OzanE1/CCM7/CCM7.docx

CCM7

STM32H750: ARM-Cortex M7-based generalized control computer. The necessary peripheral units for autonomous robotic systems are integrated. It carries 1 6DOF IMU, 1 3DOF magnetometer, 1 barometer, and 1 RF/Bluetooth module. It features 8 PWM outputs, usb, telemetry, gps, compass, PPM, and 2x20 GPIO pin outputs.

1 SYSTEM

PROCESSOR SYSTEM
N | MCU Hierarchy | MCU Name
MA | Main MCU | STM32H743VGT6
NRF | NRF MCU | nRF52820

CLOCK
N | Name | Name | Pin Name | MCU-N
X1 | 32MHz External HSE Oscillator | RCC-IN RCC-OUT | PH0 PH1 | MA
X2 | 32MHz External HSE Oscillator | RCC-IN RCC-OUT | XC1 XC2 | NRF

COM CONNECTIONS
N | Connection Name | Label | Pin Name | MCU-N
H1 | SWD | SWCLK SWDIO NRST | PA14 PA13 NRST | MA
H2 | NRF_SWD | NRF_SWCLK NRF_SWDIO NRF_NRST | SWCLK SWDIO P0.18 | NRF
H3 | USB | USB_DM USB_DP | PA11 PA12 | MA
H4 | UART1 | UART1_TX UART1_RX | PA9 PA10 | MA
H5 | UART2 | UART2_TX UART2_RX | PA2 PA3 | MA
H6 | UART3 | UART3_TX UART3_RX | PD8 PD9 | MA
H7 | UART4 | UART4_TX UART4_RX | PB9 PB8 | MA
H8 | I2C1 | I2C1_SCL I2C1_SDA I2C1_IRQ1 I2C1_IRQ2 I2C1_IRQ3 | PB6 PB7 PE13 PE14 PE15 | MA
H9 | I2C2 | I2C2_SCL I2C2_SDA | PB10 PB11 | MA
H10 | SPI1 | SPI1_SCK SPI1_MISO SPI1_MOSI SPI1_CS1 SPI1_CS2 SPI1_CS3 | PA5 PA6 PA7 PC4 PC5 PB0 | MA
H11 | SPI3 | SPI3_SCK SPI3_MISO SPI3_MOSI SPI3_CS SPI3_IRQ | PC10 PC11 PC12 PD0 PD1 | MA
H12 | NRF_SPI0 (Master) | NRF_SPI0_SCK NRF_SPI0_MISO NRF_SPI0_MOSI NRF_SPI0_CS | P0.00 P0.01 P0.04 P0.02 | NRF
H13 | NRF_SPI1 (Slave) | NRF_SPI1_SCK NRF_SPI1_MISO NRF_SPI1_MOSI NRF_SPI1_CS NRF_SPI1_IRQ | P0.05 P0.06 P0.07 P0.14 P0.15 | NRF
H14 | CAN2 | CAN2_RX CAN2_TX | PB12 PB13 | MA
H15 | PPM1 | PPM1 | PA0 | MA

PIN CONNECTIONS
N | Connection Name | Label | Pin Name | MCU-N
P1 | TIM3 | TIM3_CH1 TIM3_CH2 TIM3_CH3 TIM3_CH4 | PC6 PC7 PC8 PC9 | MA
P2 | TIM4 | TIM4_CH1 TIM4_CH2 | PD12 PD13 | MA
P3 | TRX1 | UART3_TX UART3_RX | PD8 PD9 | MA
P4 | ADC1 | ADC1 | PB0 | MA
P5 | ADC2 | ADC2 | PB1 | MA
P6 | LED0 | LED0 | PD3 | MA
P7 | LED1 | LED1 | PD4 | MA
P8 | LED2 | LED2 | PE10 | MA
P9 | LED3 | LED3 | PE11 | MA
P10 | NRF_PA | NRF_PA_RX_EN NRF_PA_TX_EN NRF_PA_MODE NRF_PA_PDN | P0.16 P0.17 P0.29 P0.08 | NRF
P11 | NRF_LED0 | NRF_LED0 | P0.28 | NRF
P12 | NRF_LED1 | NRF_LED1 | P0.30 | NRF

POWER MANAGEMENT
N | Regulator Voltage | Regulator Name | V out
E1 | VIN – 5V | TPS54202DDCR | 5V
E2 | 5V – 3.3V | ME6211C33M5G | 3V3
E3 | 5V – 3.3V | ME6211C33M5G | 3V3RF

MODULES
N | Module Name | Pinout | Peripheral
U0 | nRF21540 | 3V3RF – NRF_ANT – NRF | NRF_SPI1
U1 | nRF52820 | 3V3RF – MA | SPI3
U2 | USB Connector | DM – DP | USB
U3 | GPS Connector | 5V – TX – RX – GND | UART1
U4 | TRX Connector | 5V – TX – RX – GND | UART3
U5 | 24AA64T | 3.3V – SCL – SDA – GND | I2C1
U6 | BMI088 | 3.3V – SCK – MOSI – MISO – CS1 – CS2 – GND | SPI1
U7 | BMP581 | 3.3V – SCL – SDA – IRQ1 – GND | I2C1
U8 | BMM150 | 3.3V – SCL – SDA – IRQ2 – GND | I2C1
U9 | IIM42652 | 3.3V – SCK – MOSI – MISO – CS3 – GND | SPI1
U10 | ICP20100 | 3.3V – SCL – SDA – IRQ3 – GND | I2C1

U9 | PWM1 Connector | CH4 – 5V – GND | TIM3
| PWM2 Connector | CH3 – 5V – GND | TIM3
| PWM3 Connector | CH2 – 5V – GND | TIM3
| PWM4 Connector | CH1 – 5V – GND | TIM3
| PWM5 Connector | CH4 – 5V – GND | TIM4
| PWM6 Connector | CH3 – 5V – GND | TIM4
U10 | 2x20 2.54 Connector | 2x20 (Debug Area 2x5 : SWD + UART2,UART4) | 2x20
U11 | Power Connector | VIN – SDA – SCL – GND | I2C1
