OzanE1/CCM7/Modules/image.png

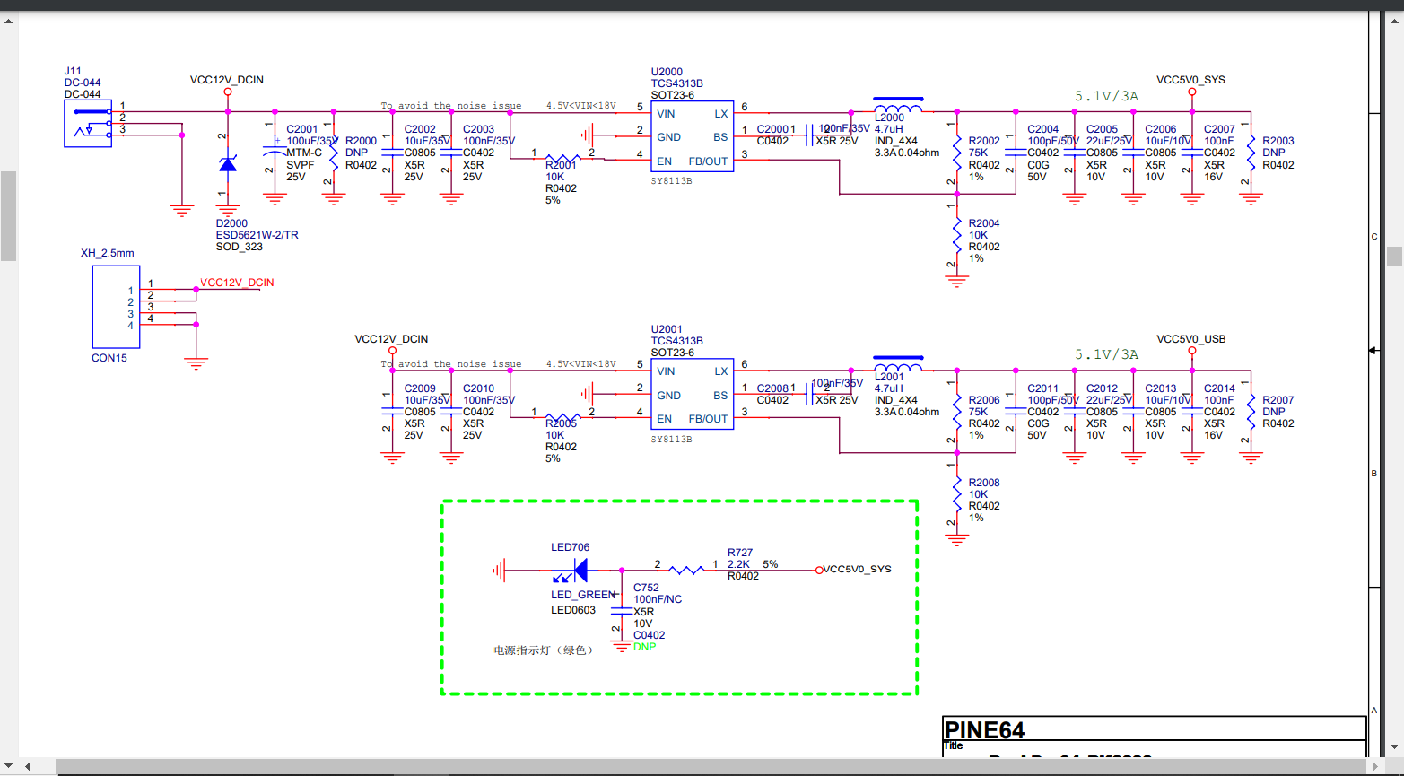
Modules/image.png
