OzanE1/CCM7/Sample-BOM_JLCSMT.xlsx

Comment | Designator | Footprint | Part Number
10uF | C1, | Capacitor_SMD:C_0603_1608Metric
10uF | C43, C57 | Capacitor_SMD:C_1206_3216Metric
100nF | C47 | Capacitor_SMD:C_1206_3216Metric
100nF | C2-C12, C14, C16, C19, C22-C27, C33, C38, C41, C42, C48, C54, C55 | Capacitor_SMD:C_0603_1608Metric
1uF | C13, C15, C36, C39, C46, | Capacitor_SMD:C_0603_1608Metric
1uF | C30, C45, C46, C50 | Capacitor_SMD:C_0805_2012Metric
2.2uF | C17, C18 | Capacitor_SMD:C_0603_1608Metric
16pF | C20, C21, C32, C44 | Capacitor_SMD:C_0603_1608Metric
2pF | C28 | Capacitor_SMD:C_0201_0603Metric
1pF | C29 | Capacitor_SMD:C_0201_0603Metric
100pF | C31 | Capacitor_SMD:C_0603_1608Metric
4.7uF | C34, C40 | Capacitor_SMD:C_0603_1608Metric
820pF | C35 | Capacitor_SMD:C_0603_1608Metric
47nF | C37 | Capacitor_SMD:C_0603_1608Metric
47pF | C49 | Capacitor_SMD:C_0603_1608Metric
100nF | C51 | Capacitor_SMD:C_0603_1608Metric
2.2uF | C52 | Capacitor_SMD:C_0603_1608Metric
10nF | C53 | Capacitor_SMD:C_0603_1608Metric
22uF | C56 | Capacitor_SMD:C_0805_2012Metric
MBR230LSFT1G | D1 | MBR230LSFT1G:SODFL3619X98N
LED | D2-D6 | LED_SMD:LED_0603_1608Metric
Polyfuse | F1 | Fuse:Fuse_1206_3216Metric
FerriteBead | FB1 | Inductor_SMD:L_0603_1608Metric
SMA_CONNECTOR | J9 | LPRS_SMA_CONNECTOR:LPRS_SMA_CONNECTOR
USB_B_Micro | J11 | Connector_USB:USB_Micro-B_Wuerth_629105150521
10uH | L1 | Inductor_SMD:L_0603_1608Metric
15nH | L2 | Inductor_SMD:L_0603_1608Metric
3.3uH | L3 | Inductor_SMD:L_Changjiang_FXL0650
1.9nH | L6 | Inductor_SMD:L_0201_0603Metric
3.0nH | L7 | Inductor_SMD:L_0201_0603Metric
4k7 | R1 | Resistor_SMD:R_0603_1608Metric
1.5k | R2, R7-R9, R14, R17 | Resistor_SMD:R_0603_1608Metric
620R | R3 | Resistor_SMD:R_0603_1608Metric
4.7k | R4, R5 | Resistor_SMD:R_0603_1608Metric
10k | R6, R15 | Resistor_SMD:R_0603_1608Metric
100K | R10 | Resistor_SMD:R_0603_1608Metric
1k | R11 | Resistor_SMD:R_0603_1608Metric
220K | R12 | Resistor_SMD:R_0603_1608Metric
30K | R13 | Resistor_SMD:R_0603_1608Metric
50R | R16 | Resistor_SMD:R_0603_1608Metric
SKRPABE010 | S1 | SW_SKRPABE010:SW_SKRPABE010
STM32H743VITx | U1 | Package_QFP:LQFP-100_14x14mm_P0.5mm
24AA64T-I/OT | U2 | Package_TO_SOT_SMD:SOT-23-5_HandSoldering
BMI088 | U3 | BMI088:PQFN50P450X300X100-16N
ICP-20100 | U4 | ICP-20100:PQFN50P200X200X85-10N
BMM150 | U5 | Package_CSP:WLCSP-12_1.56x1.56mm_P0.4mm
nRF52820-QDxx | U6 | Package_DFN_QFN:QFN-40-1EP_5x5mm_P0.4mm_EP3.6x3.6mm
NRF21540-QDAA-R7 | U7 | nRF21540:QFN65P400X400X95-17N
TPS562246DRLR | U8 | TPS562246DRLR:DRL0006A-MFG
ME6211C33M5 | U9, U10 | Package_TO_SOT_SMD:SOT-23-5
BMP581 | U11 | BMP581:BMP581
IIM-42652 | U12 | Package_LGA:Bosch_LGA-14_3x2.5mm_P0.5mm
32MHz | Y1, Y2 | Crystal:Crystal_SMD_3225-4Pin_3.2x2.5mm
