OzanE1/CCM7/EdgeCut/YeniayCC_2.dxf

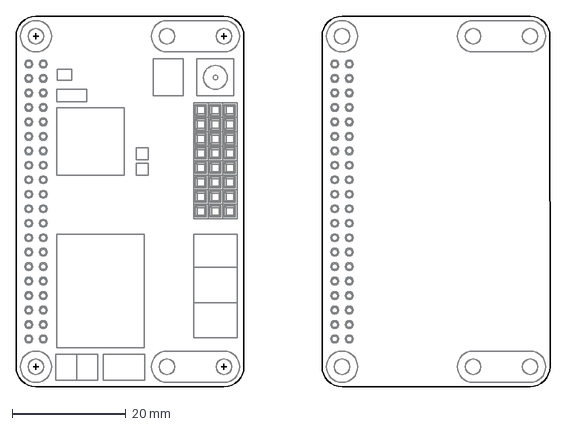
[picture p2: CAD file, 2025-02-13]
EdgeCut/YeniayCC_2.dxf
93.7 x 65.0 mm
