OzanE1/CCM7/Modules/74437349033/WE-LHMI_7050LHMI+%28rev1%29.stp

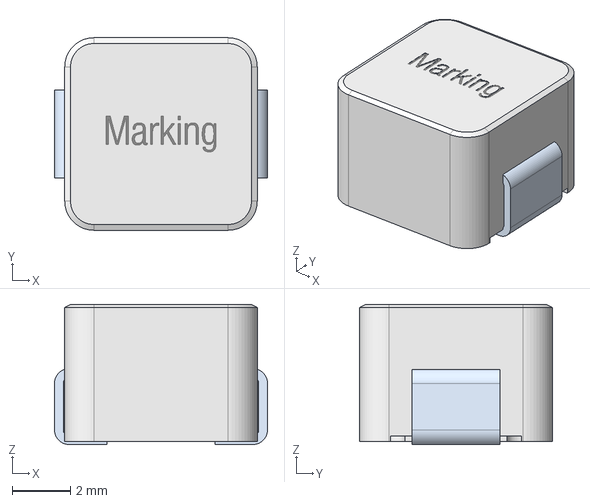
[picture p3: CAD file, 2025-04-21]
Modules/74437349033/WE-LHMI_7050LHMI+%28rev1%29.stp
7.30 x 6.60 x 4.80 mm
