OzanE1/CCM7/Modules/BMI088/BMI088--3DModel-STEP-56544.STEP

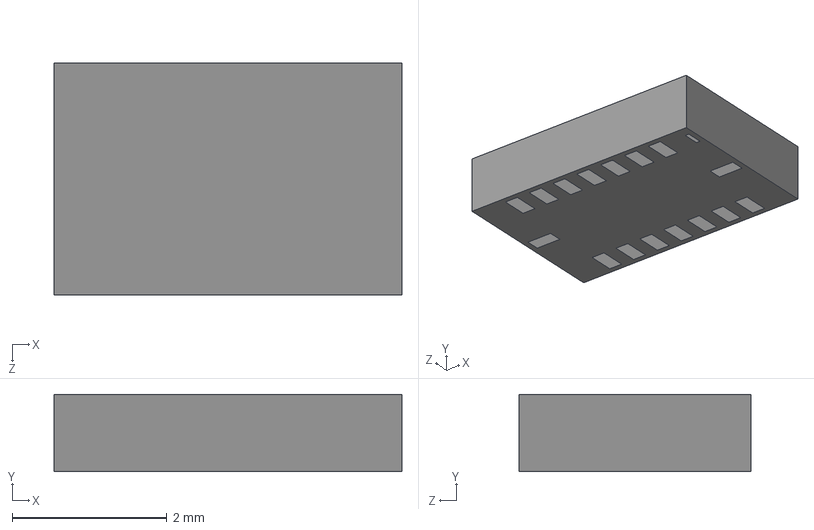
[picture p4: CAD file, 2025-04-20]
Modules/BMI088/BMI088--3DModel-STEP-56544.STEP
4.50 x 1.00 x 3.00 mm
