OzanE1/CCM7/Modules/BMM150/BMM150--3DModel-STEP-56544.STEP

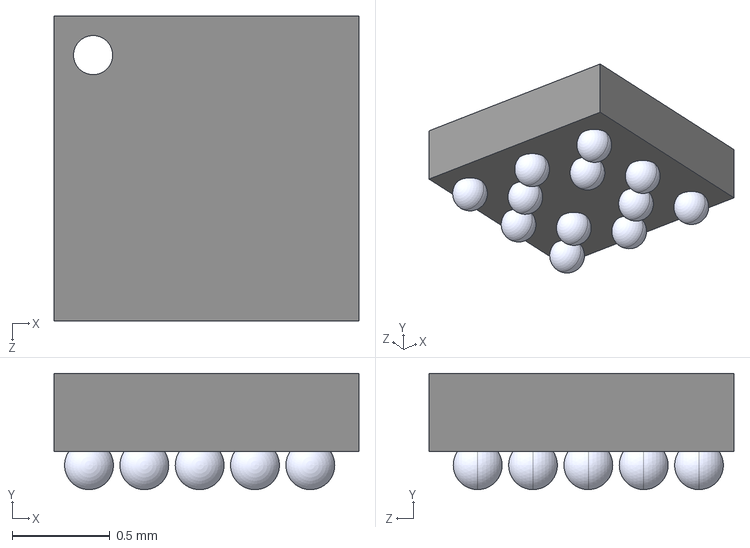
[picture p5: CAD file, 2025-04-20]
Modules/BMM150/BMM150--3DModel-STEP-56544.STEP
1.56 x 0.595 x 1.56 mm
Body^BMM150
Pin^BMM150 x 12
