OzanE1/CCM7/Modules/BMP581/BMP581--3DModel-STEP-653870.STEP

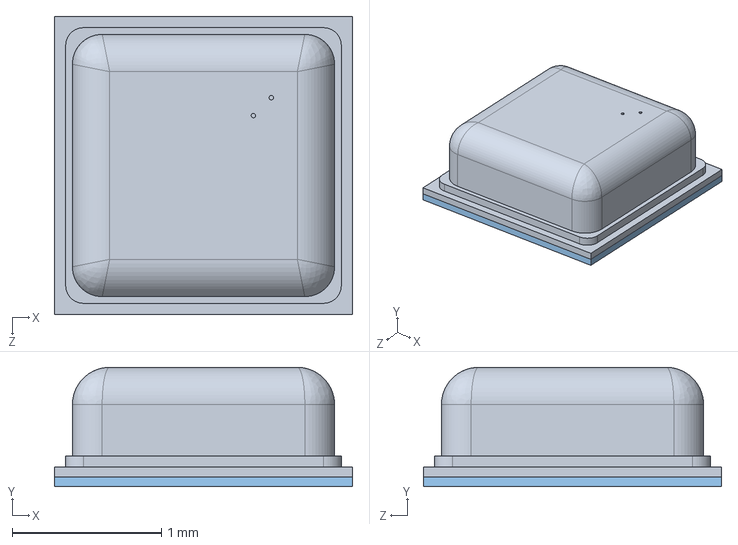
[picture p6: CAD file, 2025-04-20]
Modules/BMP581/BMP581--3DModel-STEP-653870.STEP
2.00 x 0.801 x 2.00 mm
