OzanE1/CCM7/Modules/ICP-20100/ICP-20100--3DModel-STEP-56544.STEP

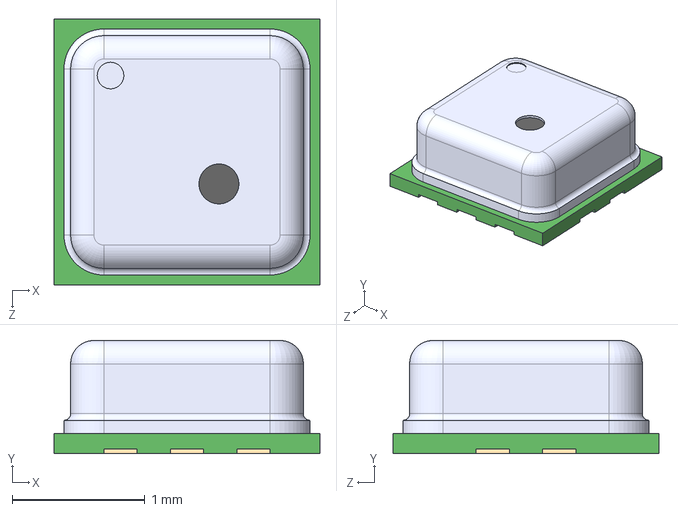
[picture p7: CAD file, 2025-04-20]
Modules/ICP-20100/ICP-20100--3DModel-STEP-56544.STEP
2.00 x 0.85 x 2.00 mm
