OzanE1/CCM7/Modules/MBR230LSFT1G/MBR230LSFT1G.STEP

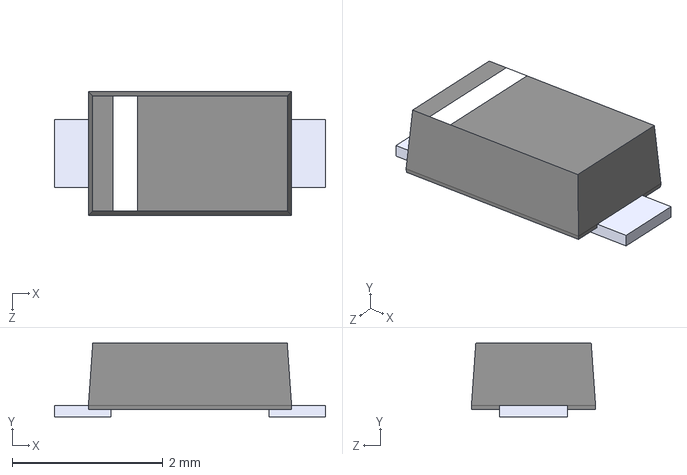
[picture p8: CAD file, 2025-04-21]
Modules/MBR230LSFT1G/MBR230LSFT1G.STEP
3.60 x 0.98 x 1.65 mm
