OzanE1/CCM7/Modules/NRF/nRF21540/QFN16_4X4_NOR.step

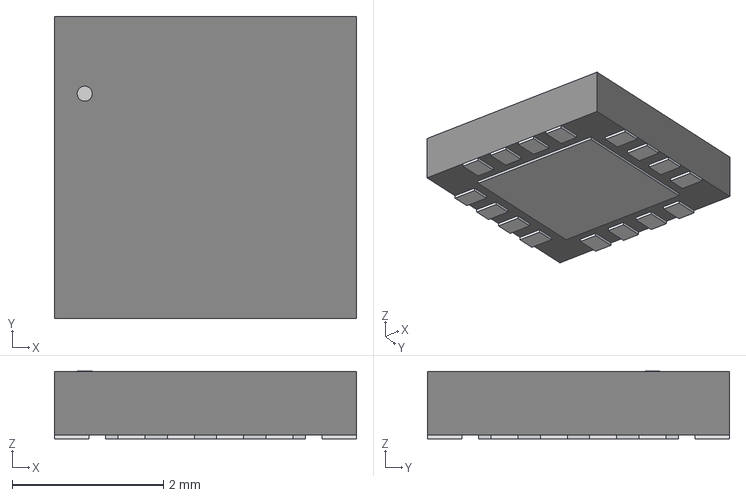
[picture p9: CAD file, 2025-04-21]
Modules/NRF/nRF21540/QFN16_4X4_NOR.step
3.99 x 3.99 x 0.892 mm
