OzanE1/CCM7/Modules/TPS562246DRLR/DRL0006A.stp

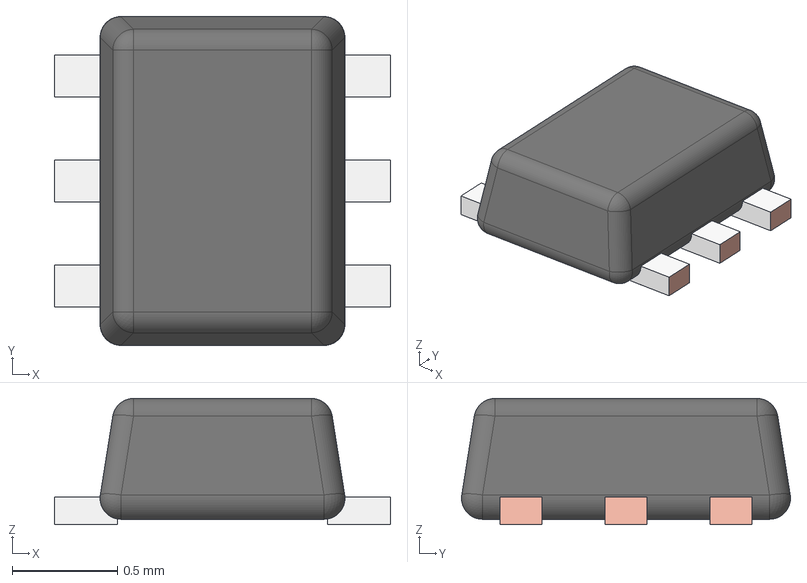
[picture p10: CAD file, 2025-04-21]
Modules/TPS562246DRLR/DRL0006A.stp
1.60 x 1.57 x 0.6 mm
FRAME-DRL0006A
BODY-SOT
PIN1-ID
