OzanE1/CCM7/Modules/USB_B_Micro_Wuerth/629105150521+%28rev1%29.stp

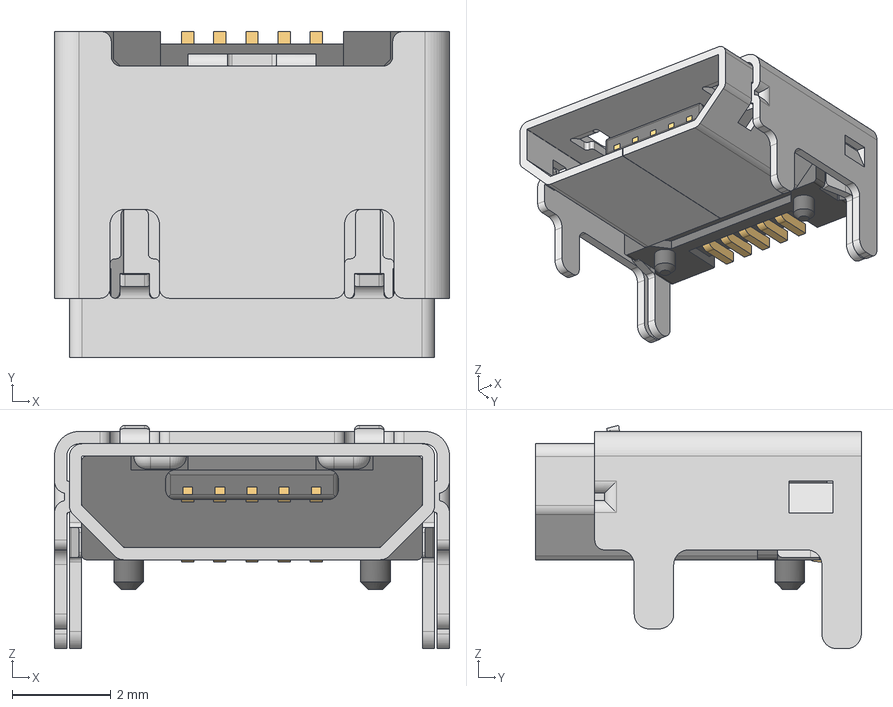
[picture p11: CAD file, 2025-04-20]
Modules/USB_B_Micro_Wuerth/629105150521+%28rev1%29.stp
8.00 x 6.60 x 4.52 mm
629105150521_Housing
629105150521_Pin1 x 4
629105150521_Pin2
629105150521_Shielding2
629105150521_Shielding
