OzanE1/CCM7/(commit log)

2024-10-31 Modules added.
    [BMM150.kicad_pcb, BMM150.kicad_sch, BMP388.kicad_pcb, BMP388.kicad_sch, ESP32-C3.kicad_pcb, ESP32-C3.kicad_sch]
2024-11-19 BMP388 updated.
    [BMP388.kicad_sch, ESP32-C3.kicad_sch, VOLTAGE_R.kicad_pcb, VOLTAGE_R.kicad_sch]
2024-11-19 BMM150 updated.
    [BMM150.kicad_sch, BMP388.kicad_sch]
2024-11-22 BMI088 updated.
    [BMI088.kicad_pcb, BMI088.kicad_sch]
2024-12-03 ESP32-C3 Updated.
2024-12-08 Voltage Regulator updated
    [VOLTAGE_R.kicad_sch]
2024-12-13 STM32H743VIT6 labels updated
    [ControlComputer.kicad_sch, ESP32-C3.kicad_sch]
2024-12-13 update schematic
    [CC_M7.kicad_sch, ESP32-C3.kicad_sch, Power.kicad_sch]
2024-12-14 nRF52820+nRf21540 add
    [CC_M7.kicad_sch, RF Telemetry.kicad_sch]
2024-12-14 update rf scheme
    [CC_M7.kicad_pcb, RF Telemetry.kicad_sch]
2024-12-15 nRF52820 schematic update
    [CC_M7.kicad_sch, Connections.kicad_sch]
2024-12-17 nrf52820 draw
    [nRF52840.kicad_pcb, nRF52840.kicad_sch]
2024-12-17 VoltageR updated
    [VOLTAGE_R.kicad_sch]
2024-12-24 label control
    [Connections.kicad_sch, ControlComputer.kicad_sch]
2024-12-27 Control board updated
    [ControlComputer.kicad_sch]
2024-12-27 Connectors updated
    [CC_M7.kicad_sch, Connections.kicad_sch, ControlComputer.kicad_sch, Power.kicad_sch]
2024-12-27 NRF pins updated
    [Connections.kicad_sch, RF Telemetry.kicad_sch, Sensors.kicad_sch]
2024-12-29 final schematic 6 warning
    [Connections.kicad_sch, ControlComputer.kicad_sch, Power.kicad_sch, RF Telemetry.kicad_sch, Sensors.kicad_sch]
2025-01-24 schematic control comment
    [Connections.kicad_sch, Power.kicad_sch, RF Telemetry.kicad_sch]
2025-02-01 CCM7.docx Updated Connector redefinition | Power Read Update
2025-02-01 Changes updated @ CCM7.docx
    [CC_M7.kicad_sch, Connections.kicad_sch, ControlComputer.kicad_sch, Power.kicad_sch, Sensors.kicad_sch]
2025-02-02 Footprint assignment 1/2
    [ControlComputer.kicad_sch, Power.kicad_sch, RF Telemetry.kicad_sch, Sensors.kicad_sch]
2025-02-08 IIM42652 schematic added
    [ControlComputer.kicad_sch, Power.kicad_sch, RF Telemetry.kicad_sch, Sensors.kicad_sch]
2025-02-08 New sensors
2025-02-08 BMP581 added schematic
    [Sensors.kicad_sch]
2025-02-09 net classes added
    [CC_M7_PCB.kicad_pcb]
2025-02-09 assigned footprint completed
    [Connections.kicad_sch, ControlComputer.kicad_sch, Power.kicad_sch, RF Telemetry.kicad_sch, Sensors.kicad_sch]
2025-02-09 BMP581 and ICP20100 added
    [ControlComputer.kicad_sch, Sensors.kicad_sch]
2025-02-12 ready to start PCB drawing
    [CC_M7.kicad_pcb, Connections.kicad_sch, Power.kicad_sch, RF Telemetry.kicad_sch, Sensors.kicad_sch]
2025-02-13 nRF PCB placement completed
    [CC_M7.kicad_pcb, ControlComputer.kicad_sch, RF Telemetry.kicad_sch, Sensors.kicad_sch, YeniayCC_2.dxf]
2025-02-18 Component placement completed
    [CC_M7.kicad_pcb, ControlComputer.kicad_sch, RF Telemetry.kicad_sch, Sensors.kicad_sch]
2025-02-18 Mounting Hole added.
    [CC_M7.kicad_pcb, CC_M7.kicad_sch, ControlComputer.kicad_sch, RF Telemetry.kicad_sch]
2025-02-20 1x04 connectors chosen and added
    [CC_M7.kicad_pcb, Connections.kicad_sch]
2025-02-21 constraints set
    [CC_M7.kicad_pcb]
2025-02-21 impadance control check and track thickness added
    [CC_M7.kicad_pcb]
2025-02-22 Schematic pdf added.
    [CC_M7.kicad_pcb, Power.kicad_sch, YeniayCC_2.dxf]
2025-02-22 Reverse current protection added.
2025-02-22 PCB track draw.
    [CCM7_Bom.csv, CC_M7.kicad_pcb, Connections.kicad_sch, ControlComputer.kicad_sch, Power.kicad_sch, RF Telemetry.kicad_sch]
2025-02-23 Reverse current protection added. | Routing progress.
    [CC_M7.kicad_pcb, Power.kicad_sch, Sensors.kicad_sch]
2025-02-23 Routing Progress | BMM150 removed.
    [CC_M7.kicad_pcb, ControlComputer.kicad_sch, RF Telemetry.kicad_sch, Sensors.kicad_sch]
2025-03-02 USB Pullup added, oscillator capacitors updated.
    [Connections.kicad_sch, ControlComputer.kicad_sch, RF Telemetry.kicad_sch]
2025-03-08 Routing | Silkscreen Design Completed. | Power Led Added. | Schematic PDF deleted | Mounting Hole Pad Clearance added. | BMM150 Conneciton Fixed.
    [CC_M7.kicad_pcb, CC_M7.kicad_sch, Connections.kicad_sch, ControlComputer.kicad_sch, Power.kicad_sch, RF Telemetry.kicad_sch, Sensors.kicad_sch]
2025-03-10 Small vias replaced big vias
    [CC_M7.kicad_pcb]
2025-03-31 error chekc
    [CC_M7.kicad_pcb]
2025-04-01 Error check
    [CC_M7.kicad_pcb]
2025-04-02 warning check
    [CC_M7.kicad_pcb, CC_M7.kicad_sch, Connections.kicad_sch, ControlComputer.kicad_sch, Power.kicad_sch, RF Telemetry.kicad_sch, Sensors.kicad_sch]
2025-04-02 Zones properties changed.
    [CC_M7.kicad_pcb]
2025-04-05 Error and warning completed check.
    [CC_M7.kicad_pcb]
2025-04-05 BOM added.
    [BOM.xlsx, CC_M7.kicad_pcb, Sample-BOM_JLCSMT.xlsx, Sensors.kicad_sch]
2025-04-20 Adding 3d models.
    [629105150521+%28rev1%29.stp, BMI088--3DModel-STEP-56544.STEP, BMM150--3DModel-STEP-56544.STEP, BMP581--3DModel-STEP-653870.STEP, CC_M7.kicad_pcb, ICP-20100--3DModel-STEP-56544.STEP]
2025-04-21 3d models added.
    [CC_M7.kicad_pcb, DRL0006A.stp, MBR230LSFT1G.STEP, QFN16_4X4_NOR.step, WE-LHMI_7050LHMI+%28rev1%29.stp]
